MatthijsRog/Teslatron-BOB/Documentation/Bill of Materials Teslatron.xlsx

Item Description Internal | Item Identifier | Mouser Number | Feedthrough Board Ref. Des. | Switchboard Ref. Des. | Amount | Unit Price | Total Price | Package Type | Comments
28 ohm ferrite beads | 742792603 | 710-742792603 | FB1-FB4 | - | 8 | €0.167 | €1.34 | 0603
150 mA 47 ohm resistors | HRG3216P-47R0-D-T1 | 754-HRG3216P47R0DT1 | R7-R14 | - | 16 | €0.781 | €12.50 | 1206
270 pF Film Capacitor | ECH-U1H271GX5 | 667-ECH-U1H271GX5 | C5-C8 | - | 8 | €0.484 | €3.87 | 0805
1 nF Film Capacitor | ECH-U1H102JX5 | 667-ECH-U1H102JX5 |  | - | 8 | €0.474 | €3.79 | 0805
Right Angle SMA Connector | 901-143-6RFX | 523-901-143-6RFX | J1-J12 | - | 24 | €7.660 | €183.84
1206 Jumper Resistor | 560112132007 | 710-560112132007 | R1-R6, R15-R20 | - | 24 | €0.122 | €2.93 | 1206
TE Connectivity Right Angle D-SUB 9pins Receptable | 5-1393480-5 | 571-5-1393480-5 | J13 | - | 2 | €5.900 | €11.80
SPDT Switches to GND | S102031MS02Q | 611-S1020301 |  | S1-S12 | 12 | €3.570 | €42.84 |  | SPST switches sold out
TE Connectivity Straight D-SUB 9pins Receptable | 4-338313-2 | 571-4-338313-2 |  | J1, J2 | 2 | €8.090 | €16.18
BNC Isolated Body Panel Feedthrough | 031-4803-RFX | 523-31-4803-RFX |  |  | 12 | €4.96 | €59.52
15mm PCB Spacer | 709905691 | 710-709905691 |  |  | 5 | €0.921 | €4.61
Enclosure 19 inch black 3U (330mm deep) | RM3U1913SBK | 546-RM3U1913SBK |  |  | 1 | €241.19 | €241.19 |  | Discontinued part
SMB Female-Female Feedthrough | 228553-1 | 571-2285531 |  |  | 24 | €9.770 | €234.48
SMB RG-316 Plug Connector | 142186 | 523-142186 |  |  | 60 | €6.710 | €402.60
SMA male crimp connector | 132178 | 523-132178 |  |  | 24 | €5.23 | €125.52 |  | Compatible with RG316 cable and our crimp tools
BNC male crimp connector | 112512 | 523-112512 |  |  | 12 | €3.82 | €45.84
 |  |  |  |  |  |  | €1392.84
