MatthijsRog/Teslatron-BOB/InventorFiles/Download_STEP_709905691 (rev1).stp

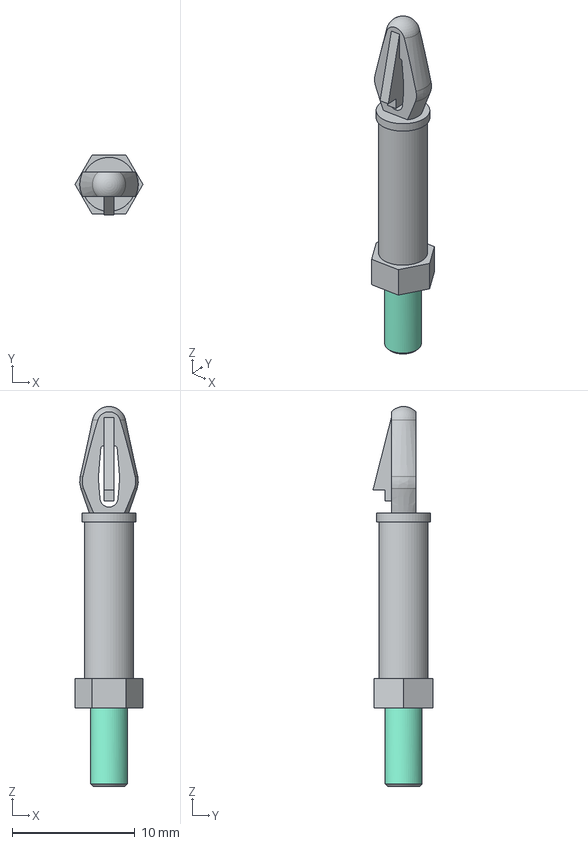
[picture p1: CAD file, 2024-04-11]
InventorFiles/Download_STEP_709905691 (rev1).stp
5.54 x 4.90 x 31.0 mm
