MatthijsRog/Teslatron-BOB/InventorFiles/GND_Switch_Board.step

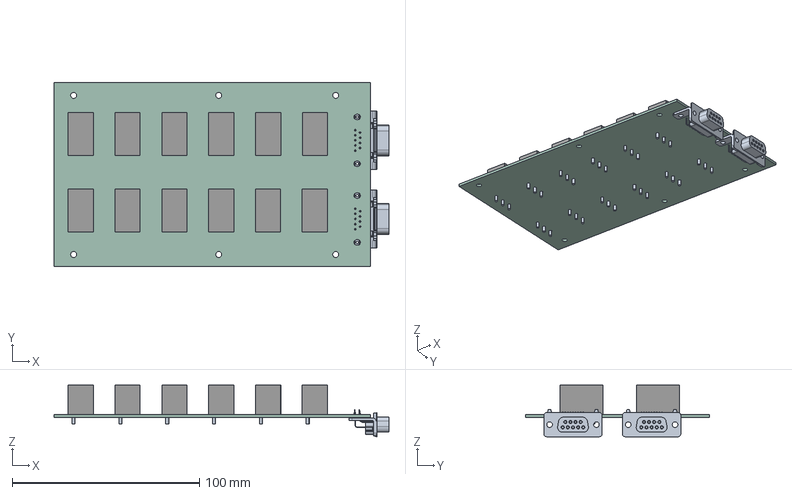
[picture p3: CAD file, 2024-04-11]
InventorFiles/GND_Switch_Board.step
179.0 x 98.5 x 27.5 mm
GND_Switch_Board PCB
