MatthijsRog/Teslatron-BOB/InventorFiles/SMA_Feedthrough_Board.step

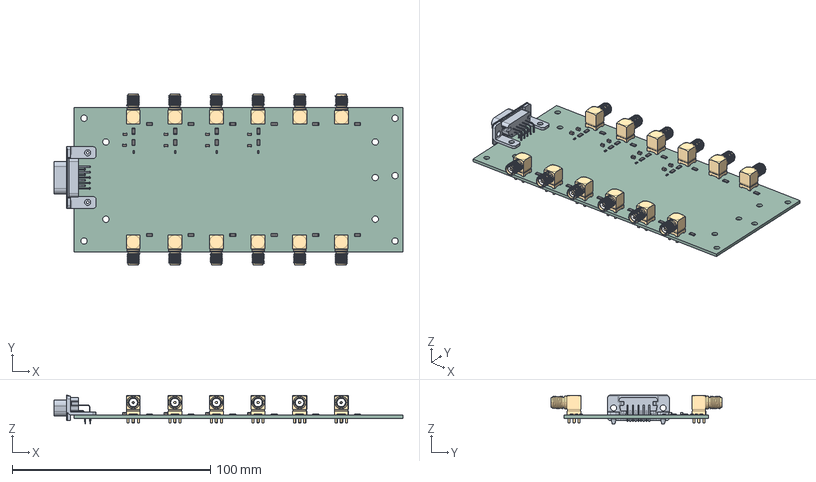
[picture p4: CAD file, 2024-04-11]
InventorFiles/SMA_Feedthrough_Board.step
176.2 x 86.2 x 14.6 mm
SMA_Feedthrough_Board PCB
