MatthijsRog/Teslatron-BOB/(list of files, cad)

Other CAD files:
InventorFiles/142186.ipt
InventorFiles/228553-1.ipt
InventorFiles/3U Front.ipt
InventorFiles/3U Mounting Bracket.ipt
InventorFiles/3U Side 13in.ipt
InventorFiles/901-143-6RFX.iam
InventorFiles/AS B194 CR1 B No. 4 x 3_8-CR1 B.ipt
InventorFiles/BOB Assembly.iam
InventorFiles/COMPOUND.ipt
InventorFiles/C_0805_2012Metric.iam
InventorFiles/Cross Recessed Flat Countersunk Head Tapping Screw - Type C - Type IA - Inch 10-24 UNC - 0.625.ipt
InventorFiles/Cross Recessed Flat Countersunk Head Tapping Screw - Type C - Type IA - Inch 6-32 UNC - 0.625.ipt
InventorFiles/Download_STEP_709905691 (rev1).ipt
InventorFiles/GND_Switch_Board PCB.ipt
InventorFiles/OldVersions/901-143-6RFX.0001.iam
InventorFiles/OldVersions/BOB Assembly.0002.iam
InventorFiles/OldVersions/COMPOUND.0001.ipt
InventorFiles/OldVersions/COMPOUND.0002.ipt
InventorFiles/OldVersions/COMPOUND.0003.ipt
InventorFiles/OldVersions/C_0805_2012Metric.0001.iam
InventorFiles/OldVersions/GND_Switch_Board.0001.iam
InventorFiles/OldVersions/RM3U1913SBK.0002.iam
InventorFiles/OldVersions/R_0603_1608Metric.0001.iam
InventorFiles/OldVersions/R_1206_3216Metric.0001.iam
InventorFiles/OldVersions/S102031MS02Q.0001.iam
InventorFiles/OldVersions/SMA_Feedthrough_Board.0001.iam
InventorFiles/OldVersions/SMA_Feedthrough_Board.0002.iam
InventorFiles/OldVersions/SOLID.0001.ipt
InventorFiles/OldVersions/SOLID.0002.ipt
InventorFiles/OldVersions/SOLID.0003.ipt
InventorFiles/OldVersions/SOLID_1.0001.ipt
InventorFiles/OldVersions/SOLID_2.0001.ipt
InventorFiles/OldVersions/SOLID_3.0001.ipt
InventorFiles/OldVersions/c-5-1393480-5-a-3d.0001.iam
InventorFiles/OldVersions/c-5-1393480-5-a-3d.0001_1.iam
InventorFiles/RM3U1913SBK.iam
InventorFiles/R_0603_1608Metric.iam
InventorFiles/R_1206_3216Metric.iam
InventorFiles/S102031MS02Q.iam
InventorFiles/SMA_Feedthrough_Board PCB.ipt
InventorFiles/SMA_Feedthrough_Board.iam
InventorFiles/SOLID.ipt
InventorFiles/SOLID_1.ipt
InventorFiles/SOLID_2.ipt
InventorFiles/SOLID_3.ipt
InventorFiles/TopA 13in.ipt
InventorFiles/c-5-1393480-5-a-3d.iam
InventorFiles/tinnerman Nut - 4-40.ipt
