MatthijsRog/Teslatron-BOB/PCB Design/GND_Switch_Board/GND_Switch_Board.kicad_pcb

## KiCad design PCB Design/GND_Switch_Board/GND_Switch_Board.kicad_pcb (2024-04-11)

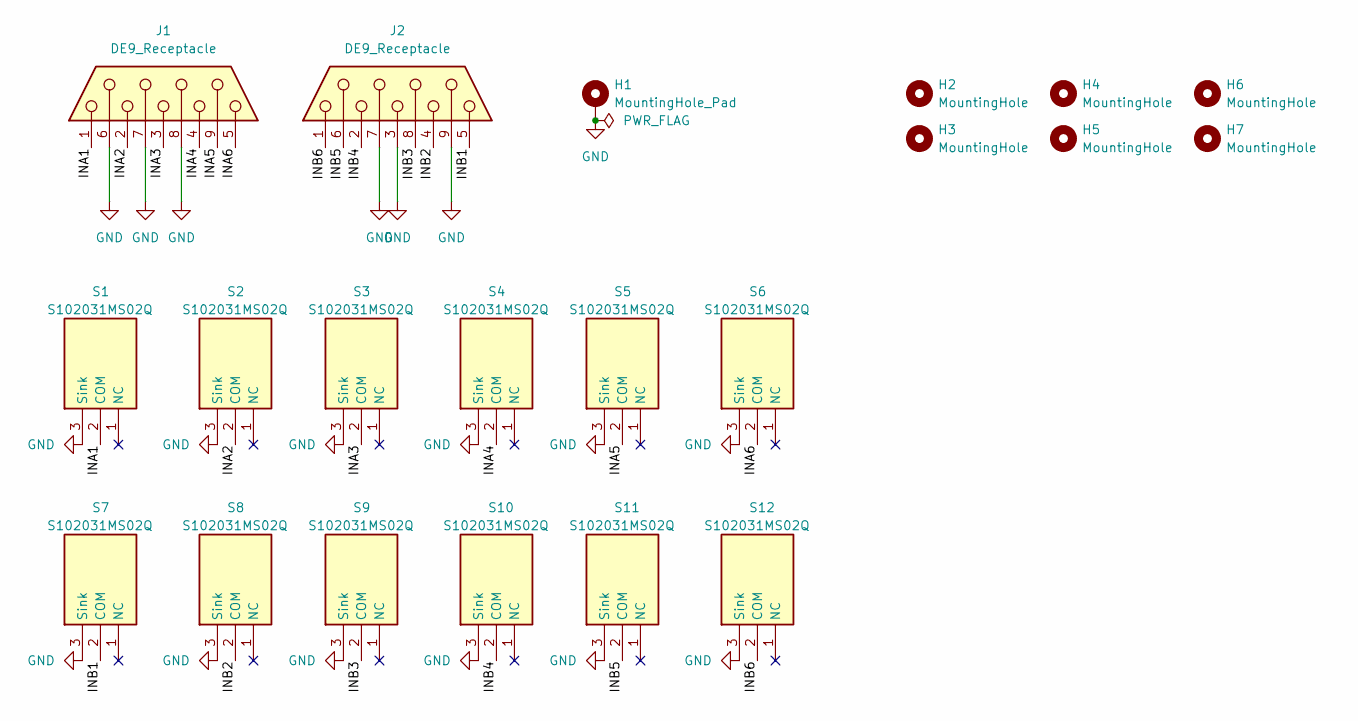
[picture p5: schematic GND_Switch_Board.kicad_sch]

Parts:
H1: MountingHole_Pad; MountingHole_3.2mm_M3_DIN965_Pad_TopBottom
H2, H3, H4, H5, H6, H7: MountingHole; MountingHole_3.2mm_M3_DIN965
J1, J2: DE9_Receptacle; 43383132
S1, S2, S3, S4, S5, S6, S7, S8, S9, S10, S11, S12: S102031MS02Q; Mouser Part Number 611-S1020301

Connections:
/INA1: J1.1, S1.2 (COM)
/INA2: J1.2, S2.2 (COM)
/INA3: J1.3, S3.2 (COM)
/INA4: J1.4, S4.2 (COM)
/INA5: J1.9, S5.2 (COM)
/INA6: J1.5, S6.2 (COM)
/INB1: J2.5, S7.2 (COM)
/INB2: J2.4, S8.2 (COM)
/INB3: J2.8, S9.2 (COM)
/INB4: J2.2, S10.2 (COM)
/INB5: J2.6, S11.2 (COM)
/INB6: J2.1, S12.2 (COM)
GND: H1.1, J1.6, J1.7, J1.8, J2.3, J2.7, J2.9, S1.3 (Sink), S2.3 (Sink), S3.3 (Sink), S4.3 (Sink), S5.3 (Sink), S6.3 (Sink), S7.3 (Sink), S8.3 (Sink), S9.3 (Sink), S10.3 (Sink), S11.3 (Sink), S12.3 (Sink)

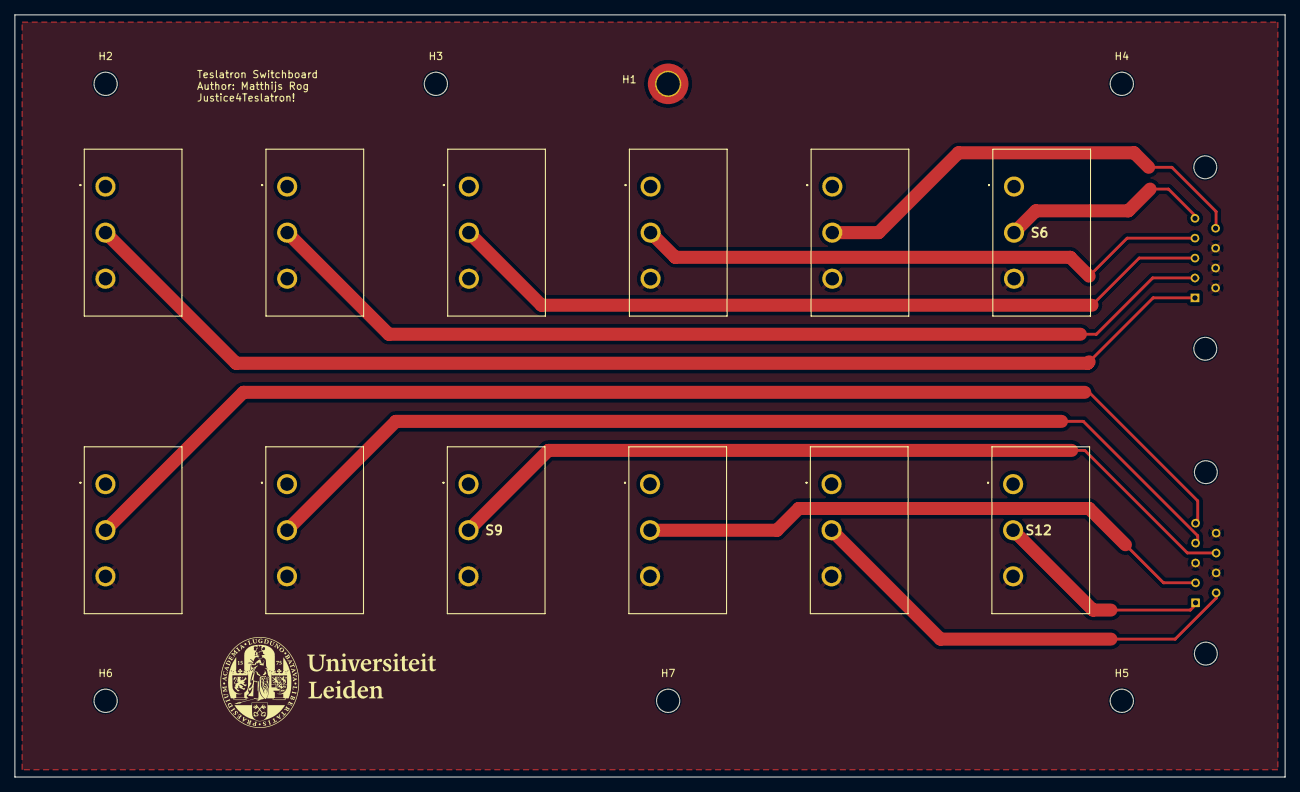
[picture p6: board GND_Switch_Board.kicad_pcb from above]

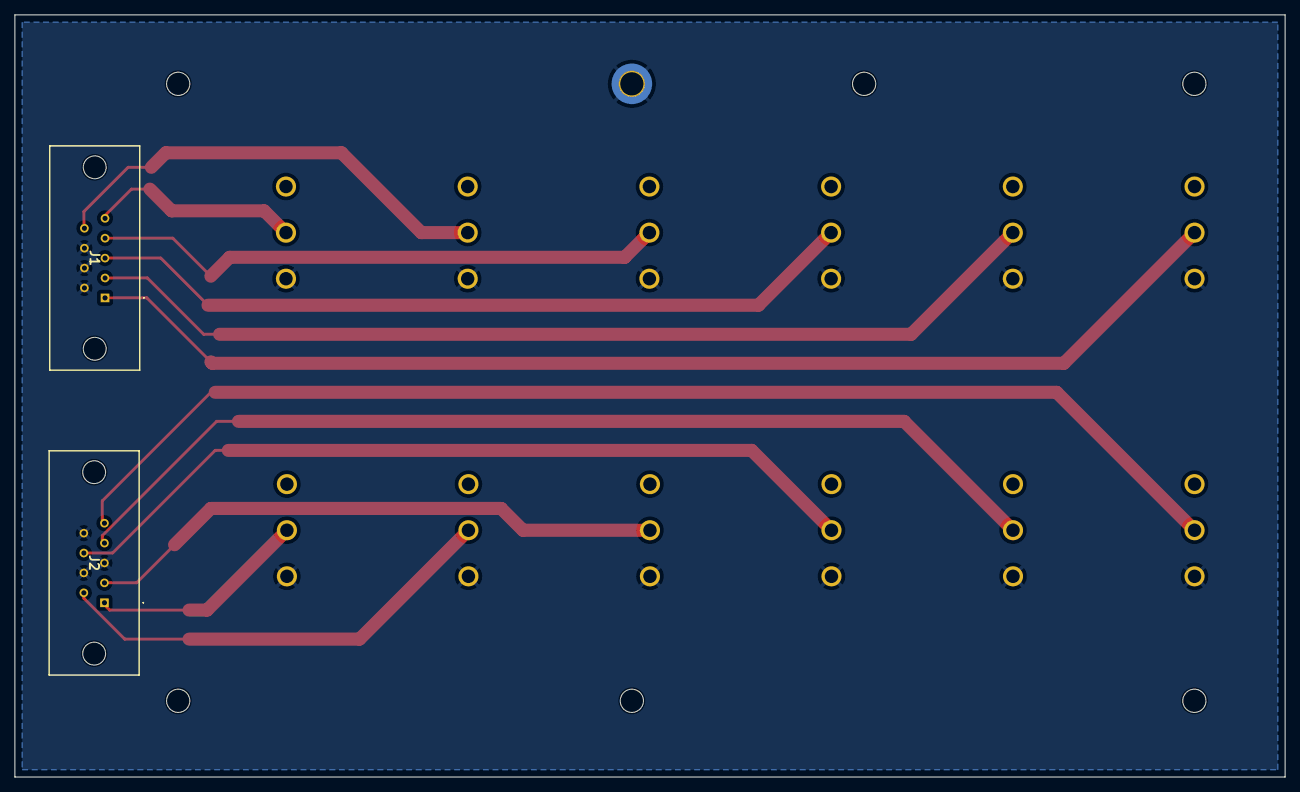
[picture p7: board GND_Switch_Board.kicad_pcb from below]

Board: 2 copper layers, 175.0 x 105.0 mm, 21 parts (2 on the bottom side), 13 nets.
