MatthijsRog/Teslatron-BOB/PCB Design/SMA_Feedthrough_Board/SMA_Feedthrough_Board.kicad_pcb

## KiCad design PCB Design/SMA_Feedthrough_Board/SMA_Feedthrough_Board.kicad_pcb (2024-04-11)

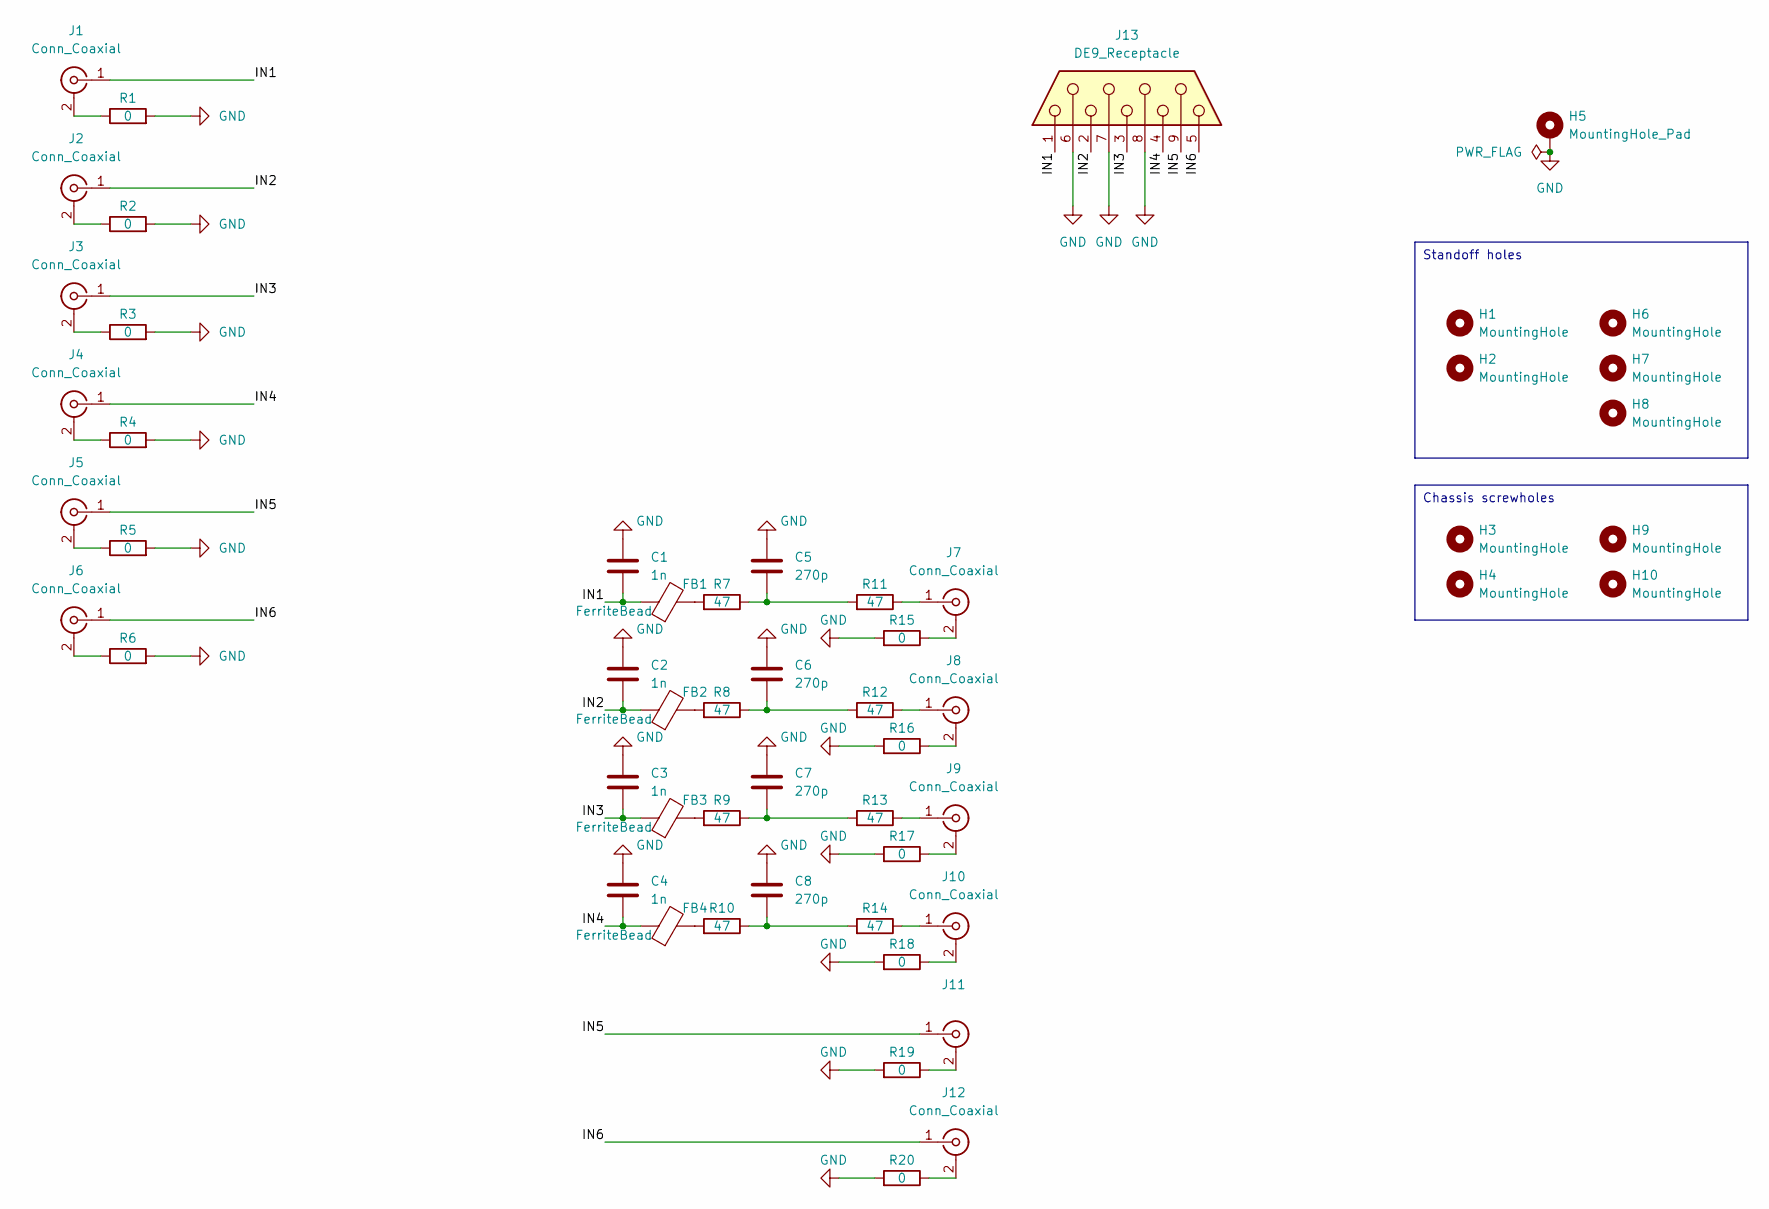
[picture p8: schematic SMA_Feedthrough_Board.kicad_sch]

Parts:
C1, C2, C3, C4: 1n; C_0805_2012Metric_Pad1.18x1.45mm_HandSolder
C5, C6, C7, C8: 270p; C_0805_2012Metric_Pad1.18x1.45mm_HandSolder
FB1, FB2, FB3, FB4: FerriteBead; R_0603_1608Metric_Pad0.98x0.95mm_HandSolder
H1, H2, H3, H4, H6, H7, H8, H9, H10: MountingHole; MountingHole_3.2mm_M3_DIN965
H5: MountingHole_Pad; MountingHole_3.2mm_M3_DIN965_Pad
J1, J2, J3, J4, J5, J6, J7, J8, J9, J10, J11, J12: Conn_Coaxial; AMPHENOL_901-143-6RFX
J13: DE9_Receptacle; 1-5393480-5
R1, R2, R3, R4, R5, R6, R15, R16, R17, R18, R19, R20: 0; R_1206_3216Metric_Pad1.30x1.75mm_HandSolder
R7, R8, R9, R10, R11, R12, R13, R14: 47; R_1206_3216Metric_Pad1.30x1.75mm_HandSolder

Connections:
/IN1: C1.2, FB1.1, J1.1 (In), J13.1
/IN2: C2.2, FB2.1, J2.1 (In), J13.2
/IN3: C3.2, FB3.1, J3.1 (In), J13.3
/IN4: C4.2, FB4.1, J4.1 (In), J13.4
/IN5: J5.1 (In), J11.1 (In), J13.9
/IN6: J6.1 (In), J12.1 (In), J13.5
GND: C1.1, C2.1, C3.1, C4.1, C5.1, C6.1, C7.1, C8.1, H5.1, J13.6, J13.7, J13.8, R1.2, R2.2, R3.2, R4.2, R5.2, R6.2, R15.2, R16.2, R17.2, R18.2, R19.2, R20.2
unnamed: C5.2, R7.1, R11.2
unnamed: C6.2, R8.1, R12.2
unnamed: C7.2, R9.1, R13.2
unnamed: C8.2, R10.1, R14.2
unnamed: FB1.2, R7.2
unnamed: FB2.2, R8.2
unnamed: FB3.2, R9.2
unnamed: FB4.2, R10.2
unnamed: J1.2 (Ext), R1.1
unnamed: J2.2 (Ext), R2.1
unnamed: J3.2 (Ext), R3.1
unnamed: J4.2 (Ext), R4.1
unnamed: J5.2 (Ext), R5.1
unnamed: J6.2 (Ext), R6.1
unnamed: J7.2 (Ext), R15.1
unnamed: J7.1 (In), R11.1
unnamed: J8.2 (Ext), R16.1
unnamed: J8.1 (In), R12.1
unnamed: J9.2 (Ext), R17.1
unnamed: J9.1 (In), R13.1
unnamed: J10.2 (Ext), R18.1
unnamed: J10.1 (In), R14.1
unnamed: J11.2 (Ext), R19.1
unnamed: J12.2 (Ext), R20.1

Notes on the sheet:
Standoff holes
Chassis screwholes

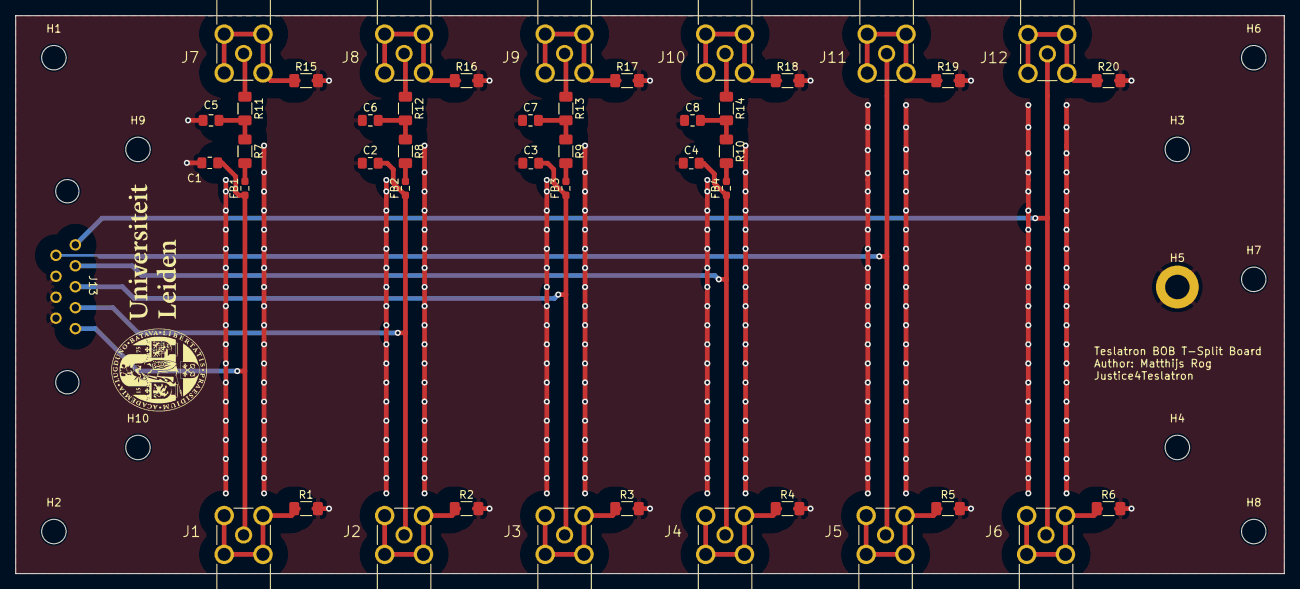
[picture p9: board SMA_Feedthrough_Board.kicad_pcb from above]

Board: 4 copper layers, 166.0 x 73.0 mm, 55 parts (0 on the bottom side), 31 nets.
